harrishyesuraj/ESP32-Joystick-Controller/README.md

# 🎮 ESP32 Game Controller

A self-contained handheld game controller built on an ESP32. It reads one analog stick and a five-button "+" cluster, shows everything on a 128×64 OLED, and works as a **Bluetooth gamepad** (Xbox / Generic PC / Android) or as a **USB serial** data source for a PC. It also runs three games on its own screen (Dino Run, Pac-Man, Snake), so it is useful with no host connected at all.

**Firmware:** v2.1 (`ESP32_Game_Controller.ino`) · **Developer:** Harrish Yesuraj P

## 📺 Video

[Watch the full detailed video on YouTube](https://youtu.be/Qe1pioXjpPk)

## 📄 Full Documentation

A complete 31-page project document (circuit, firmware architecture, settings, Bluetooth/USB protocol, games, testing, troubleshooting) is in the Documentation folder:

➡️ [`Documentation/ESP32_Game_Controller_Documentation.pdf`](Documentation/ESP32_Game_Controller_Documentation.pdf)

## 📁 Repository Structure

```
ESP32-Custom-Game-Controller/
├── firmware/
│   └── esp32_joystick.ino      # ESP32 Arduino sketch
├── host/
│   └── usb_host.py             # Python serial-to-virtual-Xbox bridge
├── tools/
│   └── oled_converter.py       # OLED image/video frame converter
├── schematics/
│   └── joystick_design.png     # Circuit diagram & schematic
├── Documentation/
│   └── xxx.pdf                 # Full 31-page project document
└── README.md
```

| What | File |
|---|---|
| Firmware (Arduino sketch) | [`firmware/esp32_joystick.ino`](firmware/esp32_joystick.ino) |
| USB-to-virtual-Xbox bridge | [`host/usb_host.py`](host/usb_host.py) |
| OLED image/video converter | [`tools/oled_converter.py`](tools/oled_converter.py) |
| Circuit diagram | [`schematics/joystick_design.jpg`](schematics/joystick_design.jpg) |
| Full documentation (PDF) | [`Documentation/ESP32_Game_Controller_Documentation.pdf`](Documentation/ESP32_Game_Controller_Documentation.pdf) |

## ✨ Features

- **Bluetooth LE gamepad** in three modes: Xbox (XInput, default), Generic PC, Android. No drivers needed in Xbox mode.
- **USB serial mode** at 115200 baud, with a PC helper (`usb_host.py`) that creates a virtual Xbox 360 controller on Windows.
- **OLED user interface**: animated boot, Nokia-style main menu, nine settings screens, operated with the controller's own controls.
- **Fully remappable**: 6 controls × 21 targets, plus ready-made layouts (D-pad, Face buttons, Racing).
- **Calibration tools**: live range calibration, orientation wizard, button-position wizard, input monitor.
- **Link test**: sends an automatic pattern so you can confirm the host really receives the right signals.
- **Built-in games**: Dino Run, Pac-Man, Snake, with loading and level-up animations and saved high scores.
- **Persistent settings** in ESP32 flash (NVS), surviving power cycles.

## 🛠️ Hardware

| Qty | Part | Notes |
|-----|---|---|
| 1 | ESP32 DevKit (ESP32-WROOM-32) | Classic ESP32, CP2102 USB bridge |
| 1 | Analog joystick module | Power from **3V3** |
| 5 | Tactile push buttons | One leg to GPIO, other leg to GND (internal pull-ups) |
| 1 | 0.96" SSD1306 OLED, 128×64, **SPI** (7-pin) | Adafruit SSD1306 library, hardware SPI |
| 1 | Green LED + 1 kΩ resistor | Status / activity |
| 1 | Breadboard, jumper wires | |
| 1 | Micro-USB **data** cable | Charge-only cables will not upload |

## 🔌 Pin Connections

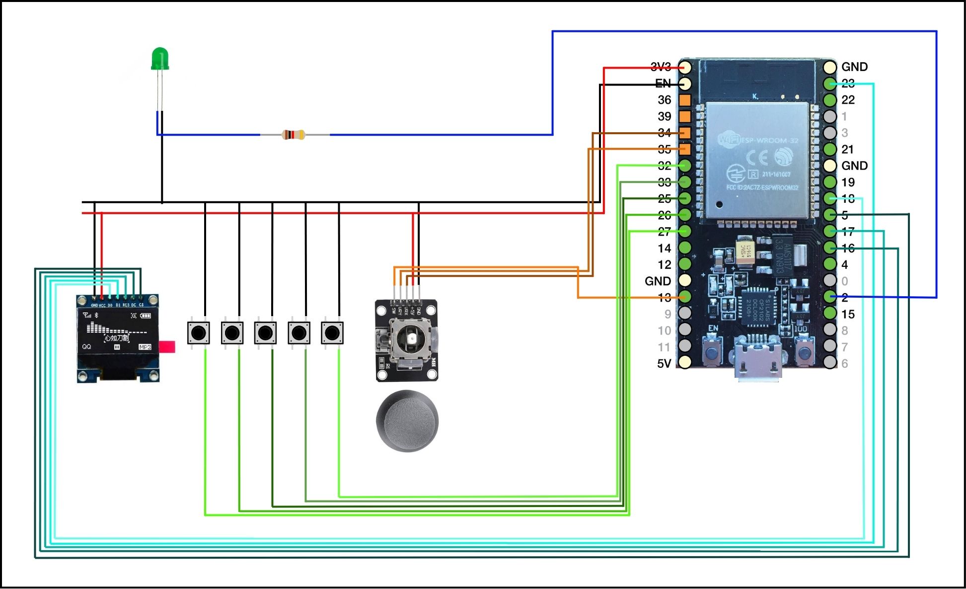
[picture p1: schematics/joystick_design.jpg]
Circuit diagram


*Circuit diagram: [`schematics/joystick_design.jpg`](schematics/joystick_design.jpg). Note: the stick's +V pin must go to 3V3, not 5V (see warning below).*

| Component | ESP32 pin |
|---|---|
| Stick VRx (X axis) | GPIO 34 |
| Stick VRy (Y axis) | GPIO 35 |
| Stick click (SW) | GPIO 13 |
| Button 1 (default Up) | GPIO 27 |
| Button 2 (default Down) | GPIO 26 |
| Button 3 (default Left) | GPIO 25 |
| Button 4 (default Right) | GPIO 33 |
| Button 5 (default Center) | GPIO 32 |
| OLED D0 (SCK) | GPIO 18 |
| OLED D1 (MOSI) | GPIO 23 |
| OLED RES | GPIO 17 |
| OLED DC | GPIO 16 |
| OLED CS | GPIO 5 |
| Status LED (via 1 kΩ) | GPIO 2 |
| OLED VCC, stick +V | 3V3 |
| All grounds | GND |

> ⚠️ **Power the stick from 3V3, not 5V.** ESP32 analog pins are not 5 V tolerant. If the stick centre reads unusually high, the firmware shows `5V? Use 3V3!` on the calibration screen.

> ℹ️ The five buttons can be wired in any order. Use **Settings → Button positions** to tell the firmware which button is Up, Down, Left, Right and Center.

## 🚀 Getting Started

### 1. Flash the firmware

1. Install the Arduino IDE and the **ESP32 board package**.
2. Install the libraries: **Adafruit GFX**, **Adafruit SSD1306**, **NimBLE-Arduino**, and **ESP32-BLE-Gamepad 0.8.0 or newer** (lemmingDev; needed for Xbox mode, may need installing from GitHub as a ZIP).
3. Select the board **ESP32 Dev Module** and the COM port of your board.
4. Open [`firmware/esp32_joystick.ino`](firmware/esp32_joystick.ino) and click **Upload**. If it stalls at "Connecting…", hold the **BOOT** button on the board.

If the compiler reports `GamepadMode` is unknown, update the library or set `#define USE_XINPUT 0`.

### 2. First-time setup (on the controller)

1. **Settings → Button positions**: press Up, Down, Left, Right, Center once each, then press any "+" button to save.
2. **Settings → Calibration → Orientation**, then **Calibrate range**: push the stick in each direction, sweep it to all edges, press Right to save.

### 3. Connect to a PC or phone

**Bluetooth:** open **Main menu → Bluetooth**, then pair "ESP32 Gamepad" (or the Xbox-style entry) in your device's Bluetooth settings. When the OLED shows `CONNECTED`, the LED is solid and the TX counter is counting. Verify with **Settings → Link test** and a web gamepad tester. If it connects but nothing is detected, remove the device from the host's Bluetooth list and pair again.

**USB serial:**

```bash
pip install pyserial vgamepad      # vgamepad is Windows only
python host/usb_host.py COM3       # use your port name
```

Script: [`host/usb_host.py`](host/usb_host.py)

Choose **Main menu → USB** on the controller first, and close the Arduino Serial Monitor. The helper turns the serial stream (`$,rx,ry,mask`) into a virtual Xbox 360 controller.

> The classic ESP32 has no native USB device, so USB mode is a serial stream, not a true plug-and-play USB gamepad. For that you need an ESP32-S2/S3 board. Bluetooth already gives a driver-free gamepad.

### 4. Or just play

**Main menu → Games** → Dino Run, Pac-Man or Snake.

## 🎨 Python Media Converter

To create your own OLED graphics and animations, use [`tools/oled_converter.py`](tools/oled_converter.py).

```bash
python -m pip install pyserial vgamepad opencv-python numpy pillow
```

Run `python tools/oled_converter.py` to launch the GUI and convert images or videos into C arrays for the Arduino code. The OLED bitmaps are 128×64, one bit per pixel.

## 🎮 Default Controls

| Control | Default function |
|---|---|
| "+" Up / Down / Left / Right | D-pad |
| "+" Center | Select (hold 1.2 s on link screens to return to the menu) |
| Analog stick | Right stick (X / Y) |
| Stick click | R3 |

Layouts can be changed in **Settings → Gamepad → Layout**, and any control can be reassigned in **Settings → Assign buttons**.

## 🧰 Troubleshooting (quick)

| Symptom | Fix |
|---|-----|
| OLED dark, LED blinks fast | Check the five SPI wires, VCC and GND |
| Stick drifts / cursor runs away | Calibrate range; check the stick is on 3V3 |
| Directions swapped or reversed | Settings → Calibration → Orientation |
| Wrong button does the wrong thing | Settings → Button positions |
| CONNECTED but host sees nothing | Forget the device, pair again |
| PC game ignores the controller | Use Xbox mode, or Steam Input |
| USB says "Host: waiting" | Close Serial Monitor and run [`host/usb_host.py`](host/usb_host.py) |

More in section 13 of the [full documentation](Documentation/xxx.pdf).

## 📜 Version History (short)

- **v1.x**: two-stick prototype, Bluetooth + USB, menus, calibration, Dino and Pac-Man.
- **v2.0**: redesign to one stick + "+" cluster, Xbox (XInput) mode.
- **v2.1**: Snake added, button-position saving fixed.

## ⚠️ Known Limitations

- USB mode is serial only (classic ESP32).
- One analog stick: the left stick is emulated by buttons.
- USB powered only, no battery.

## 🔮 Future Ideas

ESP32-S3 with native USB HID, battery and charger, more games, a PCB or 3D-printed case, OTA updates.

## 🙏 Credits

Firmware and design by **Harrish Yesuraj P**. Libraries: Adafruit GFX and SSD1306, NimBLE-Arduino, ESP32-BLE-Gamepad by lemmingDev. Bluetooth button tables based on the "Tech at Home" ESP_Bluetooth_Joystick reference project.
