harrishyesuraj/ESP32-Joystick-Controller/ESP32-Custom-Game-Controller/firmware/esp32_joystick.ino

/*
 * ESP32 Game Controller  v2.1   (one analog stick + "+" of five buttons)
 * Developer: HARRISH YESURAJ P
 *
 * LAYOUT (see the architecture document)
 *   Left thumb : five buttons in a "+" : Up, Down, Left, Right, Center
 *   Right thumb: one analog stick (X, Y) with a click button
 *   Default game mapping:  + buttons = D-pad, Center = Select/View, stick = RIGHT stick, click = R3
 *   Any of the six controls can be re-assigned: Settings > Assign buttons
 *   (D-pad, face buttons A B X Y, LB RB LT RT, Select, Start, L3, R3, left-stick directions)
 *
 * MENU KEYS  (menus, lists and games)
 *   Up / Down = move     Right = open / OK     Left = back
 *   Stick click = OK     Center = back / pause
 *   Inside Bluetooth / USB the buttons go to the game; HOLD Center for 1.2 s to open the main menu.
 *
 * BLUETOOTH MODES  (Settings > Gamepad > Mode)
 *   Xbox (XInput)  : shows up as an Xbox controller - works in Windows games, Android, Mac, Linux
 *   Generic PC / Generic Android : plain HID gamepad (web testers, old setups)
 *   Changing between Xbox and Generic needs a restart and a fresh pairing (the board restarts itself).
 *
 * LIBRARIES : Adafruit GFX, Adafruit SSD1306, NimBLE-Arduino, ESP32-BLE-Gamepad 0.8.0 or newer
 *             (install the newest ZIP from github.com/lemmingDev/ESP32-BLE-Gamepad - it adds XInput mode)
 * BOARD     : "ESP32 Dev Module"
 *
 * PINS (from the circuit diagram)
 *   Stick  : VRx 34, VRy 35, SW 13      -> power the stick from 3V3, NOT 5V (ESP32 pins are not 5 V tolerant)
 *   Buttons: 27, 26, 25, 33, 32 (left to right in the diagram; Settings > Button positions sets which is Up/Down/...)
 *   OLED   : SCK 18, MOSI 23, RES 17, DC 16, CS 5          LED: GPIO2 via resistor
 */

#include <Arduino.h>
#include <SPI.h>
#include <Adafruit_GFX.h>
#include <Adafruit_SSD1306.h>
#include <Preferences.h>
#include <BleGamepad.h>
#include <stdarg.h>
#include <pgmspace.h>

// ============================== CONFIG ====================================
#define FW_VERSION      "v2.1"
#define SETTINGS_VER    4
#define DEV_NAME        "ESP32 Gamepad"
#define USE_XINPUT      1         // 1 = offer Xbox (XInput) mode. Set 0 if the compiler says 'GamepadMode' is unknown
                                  //     (then update the ESP32-BLE-Gamepad library to 0.8.0+).

#define DEADZONE        0.12f
#define NAV_ON          0.60f
#define NAV_OFF         0.40f
#define NAV_REPEAT_1    400
#define NAV_REPEAT_N    150
#define DEBOUNCE_MS     20
#define FRAME_MS        59        // drawing rate (~17 FPS)
#define HOST_MS         10        // gamepad report period
#define USB_TIMEOUT_MS  3000UL
#define MENU_HOLD_MS    1200      // hold Center on the Bluetooth / USB screen to open the menu

#define LOAD_FRAME_COUNT   6      // game-loading animation: 6 x 120 ms = 720 ms (>= 0.6 s)
#define LOAD_FRAME_MS      120
#define LEVELUP_FRAMES     32     // level-up animation
#define LEVELUP_FRAME_MS   55
#define LEVEL_METERS       100    // Dino: speed-up + level-up every 100 m
#define PX_PER_M           12

// ============================== PINS ======================================
#define SCREEN_W   128
#define SCREEN_H   64
#define OLED_SCK   18
#define OLED_MOSI  23
#define OLED_RESET 17
#define OLED_DC    16
#define OLED_CS     5
#define PIN_LED     2

uint8_t ADC_PIN[2] = { 34, 35 };                       // stick X, stick Y
// 0 Up, 1 Down, 2 Left, 3 Right, 4 Center, 5 stick click
uint8_t BTN_PIN[6] = { 27, 26, 25, 33, 32, 13 };
const uint8_t POS_CAND[5] = { 25, 26, 27, 32, 33 };    // pins of the five "+" buttons
#define B_UP     0
#define B_DOWN   1
#define B_LEFT   2
#define B_RIGHT  3
#define B_CENTER 4
#define B_CLICK  5
#define B_JUMP   B_UP        // Dino
#define B_DUCK   B_DOWN

// ============================== LOGO ======================================
// "PRESENTED BY PHY" logo, 128x64, 1 bit/pixel (from Refine.h, array renamed phy_logo)
const unsigned char phy_logo[] PROGMEM = {
  0x00, 0x00, 0x00, 0x00, 0x00, 0x00, 0x00, 0x00, 0x00, 0x00, 0x00, 0x00, 0x00, 0x00, 0x00, 0x00,
  0x00, 0x00, 0x00, 0x00, 0x18, 0x00, 0x00, 0x00, 0x00, 0x00, 0x00, 0x00, 0x00, 0x00, 0x00, 0x00,
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
  0x40, 0x00, 0x00, 0x00, 0x00, 0x00, 0x00, 0x00, 0x02, 0x00, 0x70, 0x00, 0x00, 0x42, 0x00, 0x01,
  0x00, 0x00, 0x00, 0x00, 0x00, 0x00, 0x00, 0x00, 0x00, 0x06, 0x30, 0x00, 0x00, 0xC0, 0x40, 0x00,
  0x00, 0x00, 0x00, 0x00, 0x00, 0x00, 0x00, 0x40, 0x00, 0x00, 0x00, 0x00, 0x00, 0x00, 0x00, 0x00,
  0x00, 0x00, 0x00, 0x00, 0x00, 0x00, 0x00, 0x00, 0x00, 0x00, 0x00, 0x00, 0x00, 0x00, 0x00, 0x00,
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
};
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
void loop() {
  uint32_t now = millis();

  bool act = readInputs(now);
  genEvents(now);
  updateLink(now);

  if (act) {                                               // a sleeping screen only wakes on the first input
    lastAct = now; ledActUntil = now + 50;
    if (!displayOn) { wakeDisplay(); evn = 0; if (pressEdge[B_CENTER]) menuSwallow = true; }
  }

  for (uint8_t i = 0; i < evn; i++) { handleEvent(evq[i], now); needRedraw = true; }
  now = millis();                                          // fresh time: screens changed above stamp millis()

  if (scr == SC_DINO_PLAY) gameInput();
  if (scr == SC_SNAKE_PLAY) snakeInput();
  if (scr == SC_CAL) calTrack();
  if (scr == SC_ORIENT) oriTick(now);
  if (scr == SC_POS) posTick(now);
  if (scr == SC_LOADING && since(now, loadT0) >= (uint32_t)LOAD_FRAME_MS * LOAD_FRAME_COUNT) gotoScr(loadTarget);
  if (scr == SC_LEVELUP && since(now, lvT0) >= (uint32_t)LEVELUP_FRAME_MS * LEVELUP_FRAMES) gotoScr(lvReturn);
  if (scr == SC_CONFIRM && confKind == 4 && selConf == 1) {          // factory reset: hold the click / Right button 2 s
    if (btn[B_CLICK] || btn[B_RIGHT]) { if (!okHoldT) okHoldT = now; else if (now - okHoldT >= 2000) doConfirm(); }
    else okHoldT = 0;
  }

  sendHost(now);
  updateLed(now);

  bool noSleep = (scr == SC_DINO_PLAY || scr == SC_PAC_PLAY || scr == SC_SNAKE_PLAY || scr == SC_CAL || scr == SC_MONITOR ||
                  scr == SC_LOADING || scr == SC_LEVELUP || scr == SC_LINKTEST || scr == SC_ORIENT || scr == SC_POS);
  if (displayOn && !noSleep && TIMEOUT_MS[cfg.tmo] && since(now, lastAct) > TIMEOUT_MS[cfg.tmo]) sleepDisplay();

  // fixed 10 ms simulation steps for both games (accurate jumps and collisions)
  if (scr == SC_DINO_PLAY || scr == SC_PAC_PLAY || scr == SC_SNAKE_PLAY) {
    uint32_t d = now - lastSim; if (d > 100) d = 100;
    simAcc += d;
    while (simAcc >= 10 && (scr == SC_DINO_PLAY || scr == SC_PAC_PLAY || scr == SC_SNAKE_PLAY)) {
      if (scr == SC_DINO_PLAY) gameStep(0.01f); else if (scr == SC_PAC_PLAY) pacStep(0.01f); else snakeStep(0.01f);
      simAcc -= 10;
    }
  } else simAcc = 0;
  lastSim = now;

  if (now - lastFrame >= FRAME_MS) {
    lastFrame = now;
    if (displayOn && (needRedraw || dynamicScreen(now))) { render(now); needRedraw = false; }
  }
  delay(1);
}
